DF3MT/esp32-morse-trainer/enclosure/Morsainer.3mf

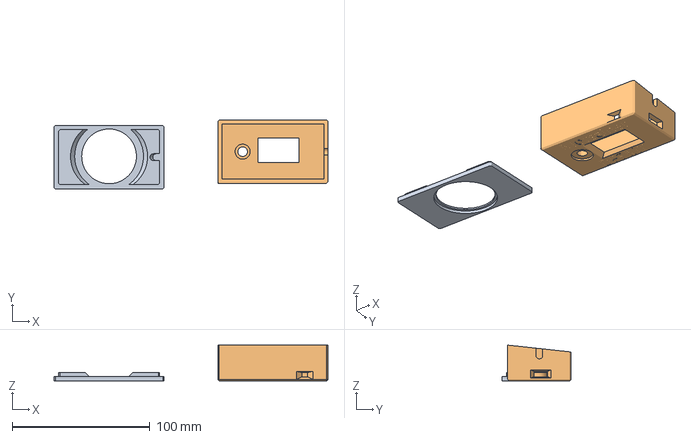
[picture p2: CAD file, 2026-11-12]
enclosure/Morsainer.3mf
199.0 x 50.1 x 26.0 mm
Lid.stl
Morsainer.stl_2
