DF3MT/esp32-morse-trainer/enclosure/Lid.stl

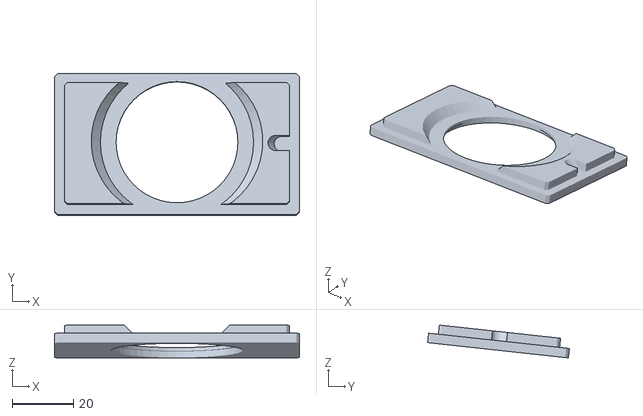
[picture p3: CAD file, 2026-11-11]
enclosure/Lid.stl
80.0 x 46.3 x 10.7
