DF3MT/esp32-morse-trainer/(list of files, cad)

Other CAD files:
enclosure/Morsainer.skp
enclosure/Morsainer.stl
