DF3MT/esp32-morse-trainer/docs/wiring_diagram.jpg

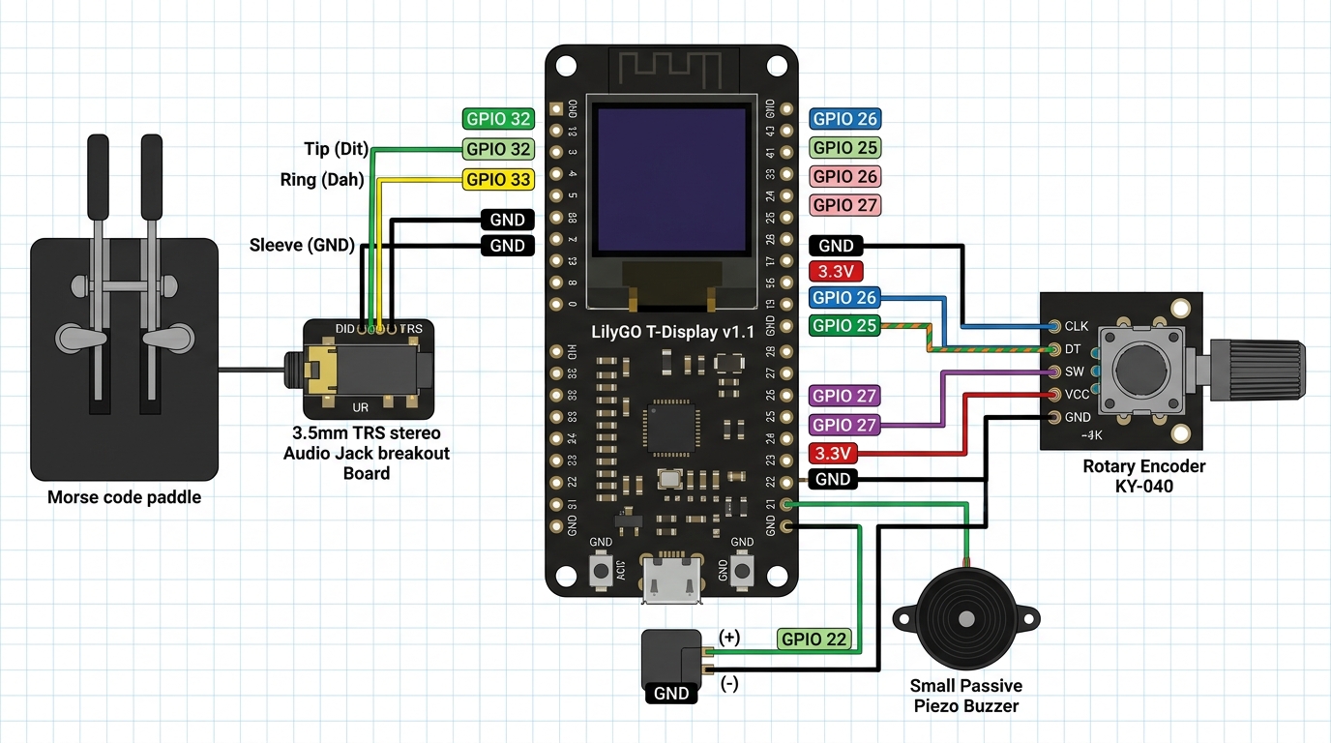
docs/wiring_diagram.jpg
