DF3MT/esp32-morse-trainer/(commit log)

2026-11-06 Initial release: ESP32 Iambic Morse Trainer & Decoder for LilyGO T-Display
2026-11-06 Fix Iambic Mode A squeeze-release timing according to Curtis 8044 / morsecode.world standards
    [keyer.cpp, keyer.h]
2026-11-06 feat(ble): add German QWERTZ / US QWERTY layout support with fix for slash and question mark
    [ble_manager.cpp, ble_manager.h, main.cpp, menu.cpp, menu.h]
2026-11-06 fix(decoder): complete 256-element Morse tree for all punctuation (. , = - : ; + ( ) @) and optimize paddle contact debounce
    [ble_manager.cpp, decoder.cpp, decoder.h, display.cpp, keyer.cpp, main.cpp]
2026-11-06 fix(ble, decoder): add AltGr+Q for @ in BLE, add squeeze-release tolerance aliases for period, comma, equals, and serial debugging
    [ble_manager.cpp, decoder.cpp, main.cpp]
2026-11-06 feat(prosigns, trainer): add amateur radio prosigns, QSO abbreviation training, squeeze tolerance, and BLE support
    [ble_manager.cpp, ble_manager.h, decoder.cpp, decoder.h, display.cpp, main.cpp, menu.cpp, menu.h]
2026-11-06 fix(encoder): invert rotary encoder rotation direction by swapping phase pins
    [menu.cpp]
2026-11-06 feat(power, splash): add fullscreen DF3MT boot splashscreen, URLs, and 2-min deep sleep standby
2026-11-06 fix(display): perfect center alignment and double-buffered rendering for DF3MT boot splashscreen
    [display.cpp]
2026-11-06 feat(splash): wait indefinitely for paddle or encoder press before starting
2026-11-06 feat(wifi, web, decoder): add standalone AP web live terminal and relax pause tolerances
    [config.h, decoder.cpp, decoder.h, display.cpp, display.h, main.cpp, menu.cpp, menu.h]
2026-11-06 feat(speed): add BpM conversion alongside WPM and revert pause tolerances
    [decoder.cpp, decoder.h, display.cpp, main.cpp, menu.cpp, menu.h]
2026-11-07 fix(sidetone): use 12-bit LEDC resolution with calibrated perceptual logarithmic curve for buzzer volume
    [menu.cpp, sidetone.cpp, sidetone.h]
2026-11-10 fix(ble): resolve connect/disconnect loop with Just Works pairing, coexistence timeouts, and Wi-Fi toggle
    [ble_manager.cpp, ble_manager.h, main.cpp, menu.cpp, menu.h, web_manager.cpp, web_manager.h]
2026-11-11 feat(ci,web-flasher): add GitHub Actions CI/CD pipeline and ESP Web Tools flasher; fix ble disconnect loop and code review issues
    [ble_manager.cpp, keyer.h, main.cpp, menu.cpp, sidetone.cpp]
2026-11-11 build: pin espressif32 platform and library versions
    CI pulled the latest espressif32 platform (Arduino core 3.x), which
    removed the ledcSetup/ledcAttachPin API used by display and sidetone.
    Pin to espressif32 6.10.0 and the library versions known to work.
2026-11-11 ci: update GitHub Actions to current major versions
    Removes the Node.js 20 deprecation warning for actions/cache and
    actions/upload-artifact.
2026-11-11 feat(i18n): switchable German/English UI, bilingual docs, shopping list
    - Add i18n module with a compile-time checked string table
    (one column per language) so more languages can be added easily
    - New first menu item "Sprache / Language", stored in NVS (default DE)
    - Translate all display screens, menu items and the web terminal;
    the web terminal follows the device language live
    - README in English (README.md) and German (README.de.md), fix
    outdated splash and wake-up pin details, document the web terminal
    - Wiring guide in English and German
    - Add shopping list (EN/DE) with AliExpress search links
    [display.cpp, i18n.cpp, i18n.h, i18n_strings.h, main.cpp, menu.cpp, menu.h, web_manager.cpp]
2026-11-11 feat(web-flasher): German/English language switch
    - DE/EN toggle in the header; initial language from ?lang=, the saved
    choice, or the browser language
    - Wiring guide and shopping list links point to the matching language
    - Add missing boot_app0.bin download card
    - Header links wrap on narrow screens
2026-11-11 feat(enclosure): add 3D enclosure models and drawings
    SketchUp source (Morsainer.skp + .skb backup), print-ready
    Morsainer.stl / Lid.stl and the Morsainer.3mf slicer project.
    [Lid.stl, Morsainer.3mf, Morsainer.skp, Morsainer.stl]
2026-11-12 feat(enclosure): update enclosure model
    Revised SketchUp model with re-exported Morsainer.stl and updated
    Morsainer.3mf slicer project.
    [Morsainer.3mf, Morsainer.skp, Morsainer.stl]
2026-11-12 fix(ble): end connect/disconnect loop caused by stale host bonds
    A host that still held a bond the keyer had lost (e.g. after the
    bond store was wiped) reconnected every ~0.5 s and dropped the link
    with 0x13. The keyer now advertises with a static random identity
    address that is regenerated whenever no bonds are stored (and on
    "reset bonds"), with resolvable private addresses disabled so the
    host cannot match its old IRK. Once paired, the address is kept in NVS.
    - request security right after connect
    - BLE off/on in the menu no longer re-runs BleKeyboard::begin()
    (duplicate services); it stops/starts advertising and drops peers
    - GAP diagnostics on the serial console: disconnect reason,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
    [ble_manager.cpp]
